neu350/H1/README.md

# H1
Resources for fly H1 visual interneuron electrophysiology experiment

Contents:

- stimulus_strips.ps - postscript file of stimulus strips for visual display.
- BarPatterns.m - matlab script to generate stimulus strips.  The random strip will generate uniquely each time this 
- h1drum.py - python 3.x code for generation of a visual GUI to interact with the stim-spinner device.
- StepperClassroomV1.0.ino - Arduino sketch to control stim-spinner device.
- spinner folder - contains schematics and part list for fabricating the StimSpinner device
