neu350/H1/spinner/README.md

This folder contains information pertaining to the fabrication of the StimSpinner device used to present rotating visual stimuli to flies as part of the H1 experiment.

Numbers in brackets correspond to components in BOM list.
