neu350/H1/spinner/StimSpinner_InteriorRendering.pdf

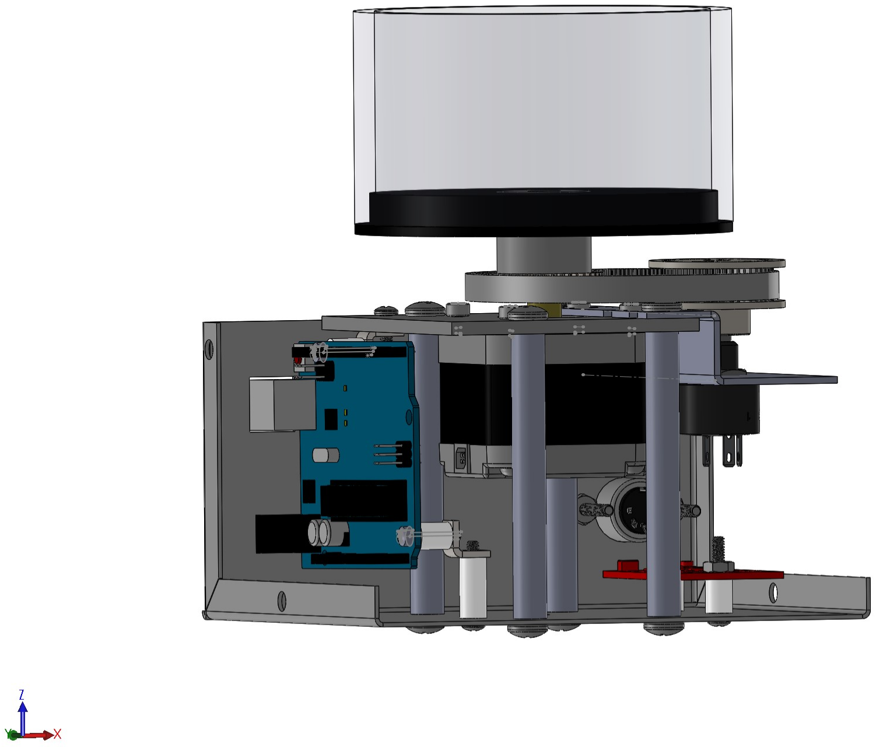
[picture p1: page 1]
