neu350/H1/spinner/StimSpinner_BOM.pdf

ITEM NO. | PART NUMBER | DESCRIPTION | QTY.
1 | plate | Motor Mount | 1
2 | base-cu-3007 | Base of Bud Box CU-3007-A | 1
3 | spacer | 5/8 Aluminum Rod | 4
4 | sheet-bend | Potentiometer Mount | 1
5 | ROB-09238 | Stepper Motor | 1
6 | BNC | BNC Bulkhead Connector | 1
7 | DIN 5 Connector (Female) | Power Connector | 1
8 | brass_sleeve | | 1
9 | 94639A207 | 5/16" Nylon Spacer | 4
10 | 94639A698 | 9/16" Nylon Spacer | 1
11 | Bracket 4-40 621 | | 2
12 | Cylinder_Base_Plate | | 1
13 | 8486K371_clear_cyli nder | 2" of Clear Acrylic Tube 3-1/2" OD x 3-1/4" ID | 1
14 | RV4LF0GSF103MA-VISHAY.STP | 5K Rotary Potentiometer | 1
15 | Arduino | | 1
16 | Big Easy Driver stp.step | Stepper Motor Driver | 1
17 | spur-gear | | 1
18 | 2662N25 | Plastic Belt Pulley | 1
19 | 7887K223 | Timing Belt | 1
20 | 91292A109 | Socket Head Screw M3x0.5mm 4mm Long | 4
21 | 91772A827 | Screw 10-32 3/8" | 8
22 | 91772A113 | Screw 4-40 3/4" | 6
23 | 91737A084 | Narrow Fillister Head Screw 4-40 1/2" | 2
24 | 91841A005 | Nut 4-40 | 3
25 | 91375A144 | Cup-Point Set Screw 6-32 1/4" | 1
26 | cover-cu-3007 | Cover of Bud Box CU-3007-A | 1
27 | 92562A234 | Socket Head Screw 10-24 1/2" | 1
A | A
B | B

2

2

1

1

SIZE A | DWG. NO. StimSpinnerBOMSHEET 1 OF 1 | REV.
SCALE:1:5 | WEIGHT:
