neu350/H1/spinner/StimSpinner_PartsList.pdf

Newark # | #/Unit | Description
30H5040 | 2 | KEYSTONE 621 MOUNTING BRACKET
08N6813 | 1 | MULTICOMP 2226A-02 Connector Housing, 2226 Series, Receptacle, 2 Positions, 2.54 mm
08N6814 | 1 | MULTICOMP 2226A-03 Connector Housing, 2226 Series, Receptacle, 3 Positions, 2.54 mm
08N6815 | 2 | MULTICOMP 2226A-04 Connector Housing, 2226 Series, Receptacle, 4 Positions, 2.54 mm
08N6818 | 1 | MULTICOMP 2226A-08 Connector Housing, 2226 Series, Receptacle, 8 Positions, 2.54 mm
08N6834 | 25 | MULTICOMP 2226TG Contact, 2226 Series, Socket, Crimp, 24 AWG, Gold Plated Contacts
08N6750 | 1 | KEYSTONE 621 MOUNTING BRACKET
08N6746 | 1 | MULTICOMP 2211S-04G Pin Header, Board-to-Board, 2.54 mm, 1 Rows, 4 Contacts, Through Hole Straight, 2211S Series
08N6744 | 1 | MULTICOMP 2211S-02G Pin Header, Board-to-Board, 2.54 mm, 1 Rows, 2 Contacts, Through Hole Straight, 2211S Series
79P9326 | 1 | SAMTEC TSW-108-09-T-S-RA Pin Header, Board-to-Board, 2.54 mm, 1 Rows, 8 Contacts, Through Hole Right Angle, TSW Series
05M4060 | 1 | BUD CU-3007-A Metal Enclosure, Minibox, Small, Aluminium, 101.6 mm, 127 mm, 152 mm
71J0171 | 1 | XP POWER PCM50UT04 AC/DC Power Supply, 3 Output, 42 W, 5 V, 5 A, 12 V, 2 A
98K6011 | 1 | VOLEX 17250 10 B1 Mains Power Cord, NEMA 5-15P to IEC 60320 C13, 2.3 m, 10 A, 125 VAC, Black
83H7885 | 1 | ETI SYSTEMS SP22G-5K Rotary Potentiometer, Conductive Plastic, 5 kohm, 1 Turns, Linear, 1 W, ± 10%, SP22G Series
67AC3850 | 1 | HIRSCHMANN MAB 5 DIN AUDIO/VIDEO CONN, JACK, 5POS, STEEL
79K4997 | 1 | MULTICOMP SPC15415 RF / Coaxial Connector, BNC Coaxial, Straight Bulkhead Jack, Solder, 50 ohm, Brass
McMaster-Carr | #/Unit | Description
91737A084 | 5 | Narrow Fillister Head Phillips Screws, High-Profile, 4-40 Thread, 1/2" Long
91841A005 | 3 | 18-8 Stainless Steel Hex Nut, 4-40 Thread Size
91772A113 | 2 | 18-8 Stainless Steel Pan Head Phillips Screw, 4-40 Thread, 3/4" Long
91772A827 | 8 | 18-8 Stainless Steel Pan Head Phillips Screw, 10-32 Thread, 3/8" Long
91292A109 | 4 | 18-8 Stainless Steel Socket Head Screw M3 x 0.5 mm Thread, 4 mm Long screw
94639A207 | 4 | Off-White Nylon Unthreaded Spacer, 1/4" OD, 5/16" Long, for Number 4 Screw Size
94639A698 | 2 | Off-White Nylon Unthreaded Spacer, 1/4" OD, 9/16" Long, for Number 4 Screw Size
91375A144 | 1 | Cup-Point Set Screw, 6-32 Thread, 1/4" Long
92562A234 | 1 | Socket Head Screw, 10-24 Thread Size, 1/2" Long
8486K371 | 2 inch | Clear Cast Acrylic Tube, 3-1/2" OD x 3-1/4" ID
SparkFun | #/Unit | Description
ROB-12859 | 1 | Big Easy Driver
ROB-09238 | 1 | Stepper motor
| 1 | Arduino Uno – R3
PRT-14340 | 1 | Medium Heatsink
PRT-17054 | | Thermal Tape 4x4" Square
SDP/SI | #/Unit | Description
Pully | 1 | A 6Z 6-40DF02508
Timing Belt | 1 | A 6R 6-0850250
