neu350/H1/spinner/[12] Cylinder_Base_Plate.pdf

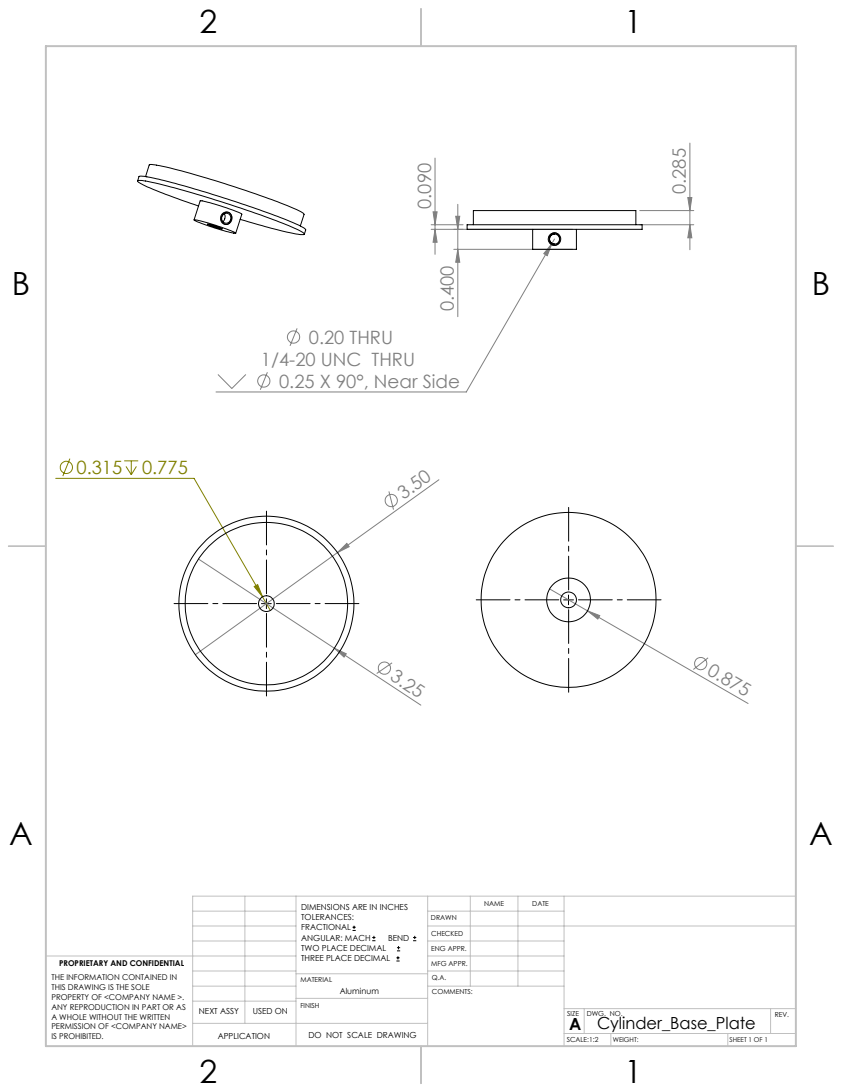
[picture p2: page 1]
0.20 THRU 1/4-20 UNC THRU 0.25 X 90°, Near Side

TOLERANCES: FRACTIONAL ANGULAR: MACH BEND TWO PLACE DECIMAL THREE PLACE DECIMAL | | NAME | DATE DIMENSIONS ARE IN INCHES

DRAWN
CHECKED
ENG APPR.

PROPRIETARY AND CONFIDENTIAL THE INFORMATION CONTAINED IN THIS DRAWING IS THE SOLE PROPERTY OF <COMPANY NAME >. ANY REPRODUCTION IN PART OR AS A WHOLE WITHOUT THE WRITTEN PERMISSION OF <COMPANY NAME> IS PROHIBITED. | | | MFG APPR.

MATERIAL Aluminum | Q.A.

NEXT ASSY | USED ON | FINISH

SIZE A | DWG. NO. Cylinder_Base_Plate | REV.

APPLICATION | | DO NOT SCALE DRAWING

SCALE:1:2 | WEIGHT: | SHEET 1 OF 1
