neu350/H1/spinner/[17] spur_gear.pdf

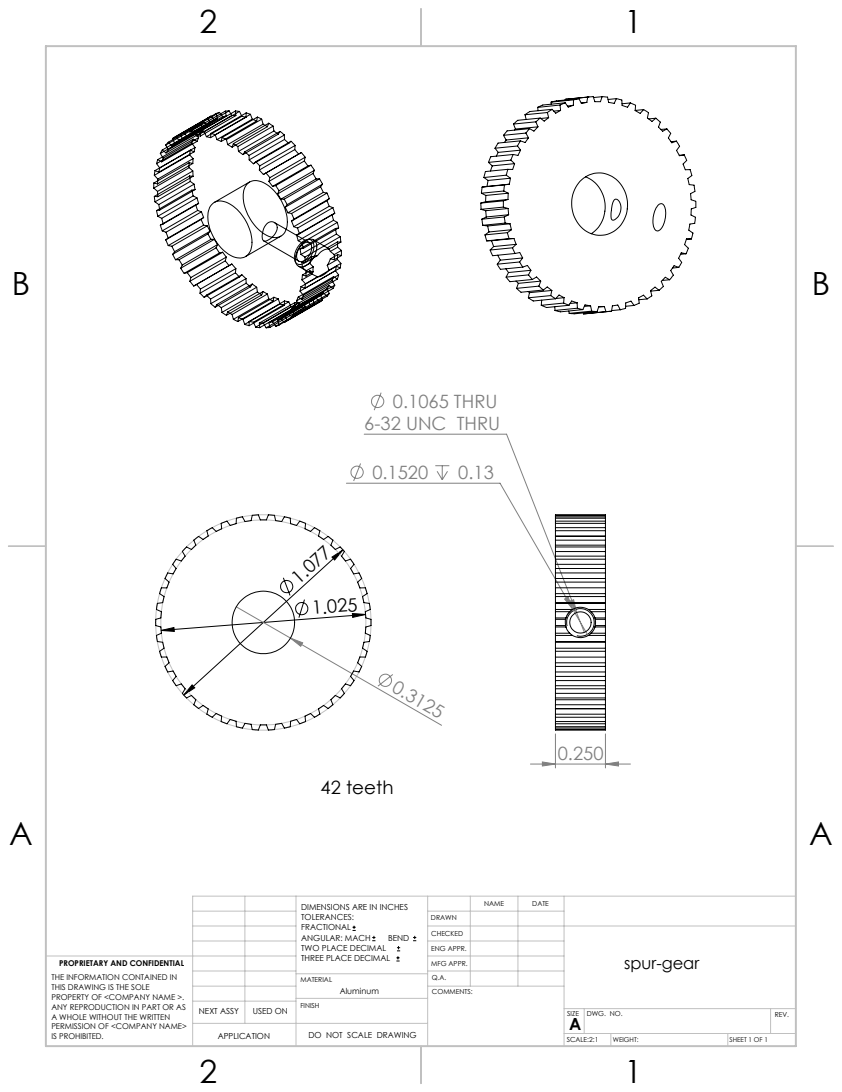
[picture p3: page 1]
0.1065 THRU 6-32 UNC THRU; 42 teeth

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

DRAWN
CHECKED | | | spur-gear
ENG APPR.

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

MATERIAL Aluminum | Q.A.

NEXT ASSY | USED ON | FINISH

SIZE A | DWG. NO. | REV.

APPLICATION | | DO NOT SCALE DRAWING

SCALE:2:1 | WEIGHT: | SHEET 1 OF 1
