neu350/H1/spinner/[1] plate.pdf

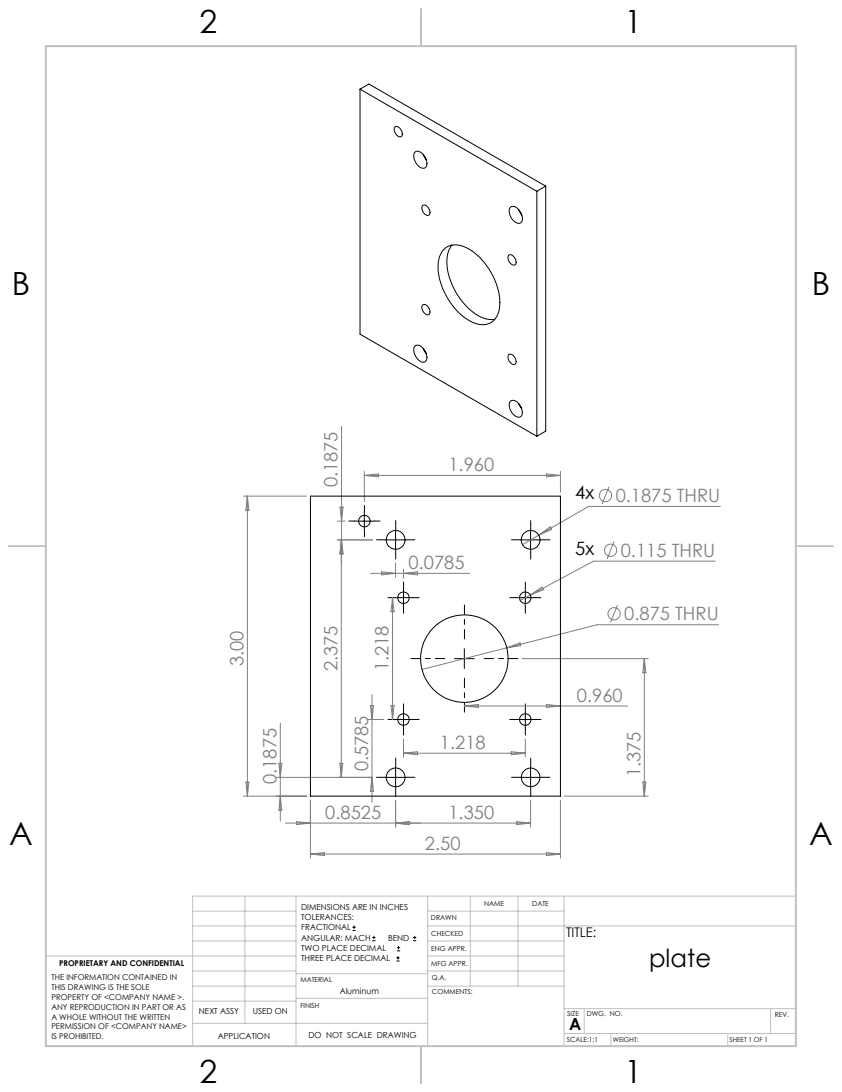
[picture p4: page 1]
0.1875 THRU; 0.115 THRU; 0.875 THRU; PROPRIETARY AND CONFIDENTIAL; plate THE INFORMATION CONTAINED IN

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

DRAWN
CHECKED | | | TITLE:

ENG APPR.

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

MATERIAL Aluminum | Q.A.

NEXT ASSY | USED ON | FINISH

SIZE A | DWG. NO. | REV.

APPLICATION | | DO NOT SCALE DRAWING

SCALE:1:1 | WEIGHT: | SHEET 1 OF 1
