neu350/H1/spinner/[3] spacer.pdf

B B

2

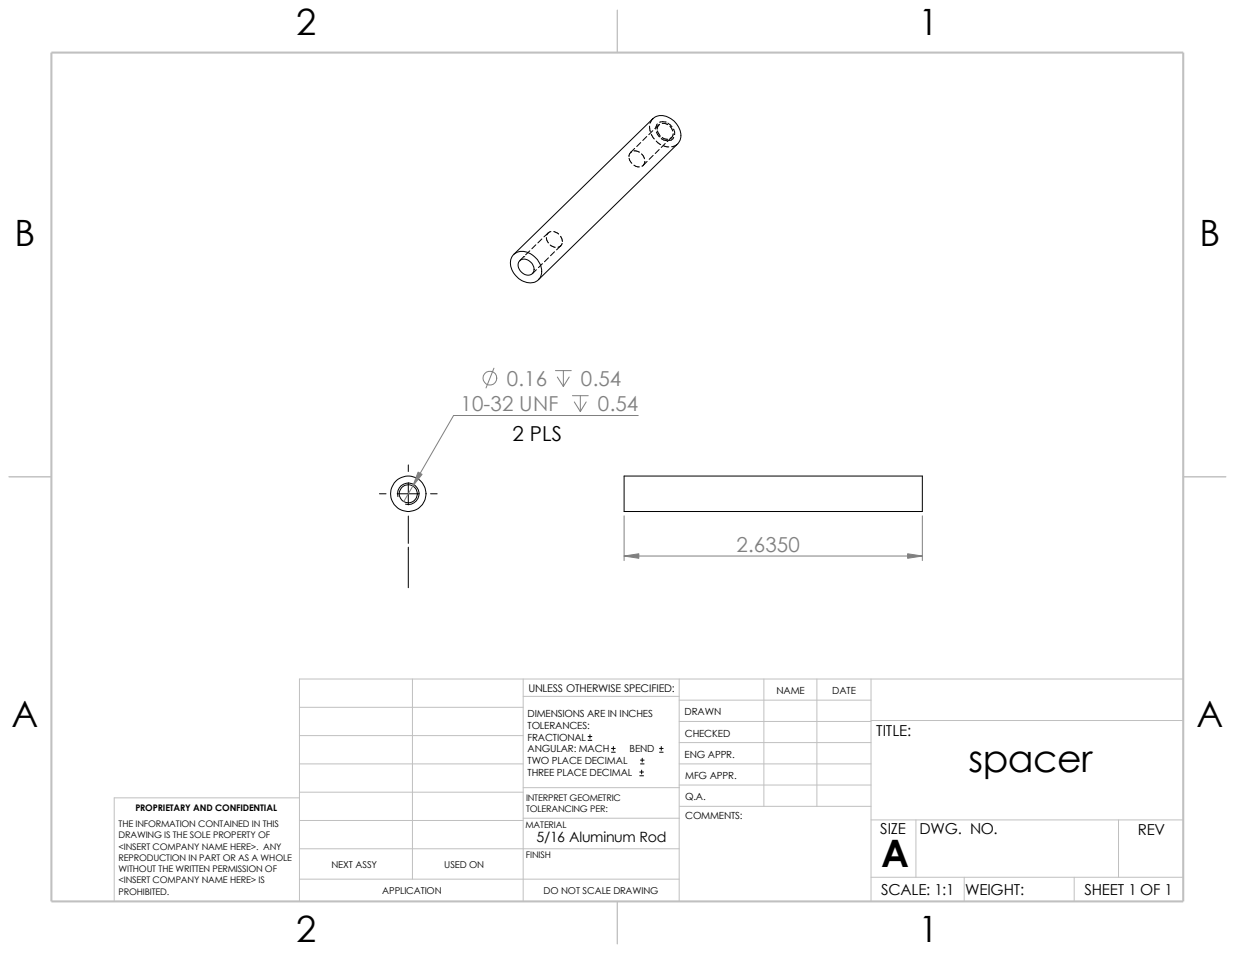
[picture p5: page 1]
10-32 UNF; COMMENTS:; INTERPRET GEOMETRIC; PROPRIETARY AND CONFIDENTIAL; TOLERANCING PER:; 2 PLS

UNLESS OTHERWISE SPECIFIED: | | NAME | DATE

DIMENSIONS ARE IN INCHES TOLERANCES: FRACTIONAL ANGULAR: MACH BEND TWO PLACE DECIMAL THREE PLACE DECIMAL | DRAWN

CHECKED | | | TITLE: spacer

ENG APPR.
MFG APPR.

THE INFORMATION CONTAINED IN THIS
DRAWING IS THE SOLE PROPERTY OF
<INSERT COMPANY NAME HERE>. ANY
REPRODUCTION IN PART OR AS A WHOLE
WITHOUT THE WRITTEN PERMISSION OF
<INSERT COMPANY NAME HERE> IS
PROHIBITED.

MATERIAL 5/16 Aluminum Rod | | SIZE A | DWG. NO. | REV

NEXT ASSY | USED ON | FINISH

APPLICATION | DO NOT SCALE DRAWING | | SCALE: 1:1 | WEIGHT: | SHEET 1 OF 1
