neu350/H1/spinner/[26] cover-cu-3007.pdf

B B

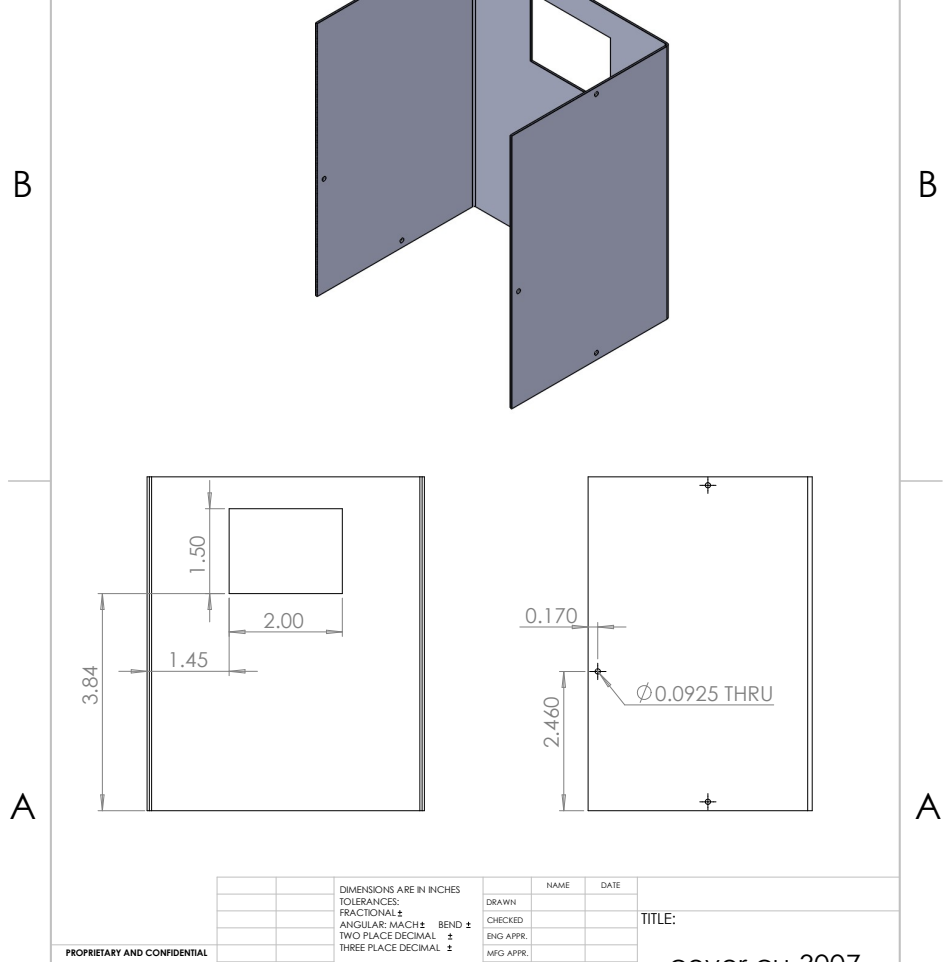
[picture p7: page 1]
ANGULAR: MACH; BEND; TITLE:; 0.0925 THRU

NAME DIMENSIONS ARE IN INCHES | DATE

TOLERANCES:
FRACTIONAL
TWO PLACE DECIMAL
THREE PLACE DECIMAL

DRAWN

CHECKED
ENG APPR.

PROPRIETARY AND CONFIDENTIAL

cover cu-3007 MFG APPR.
