neu350/H1/spinner/[2] base-cu-3007.pdf

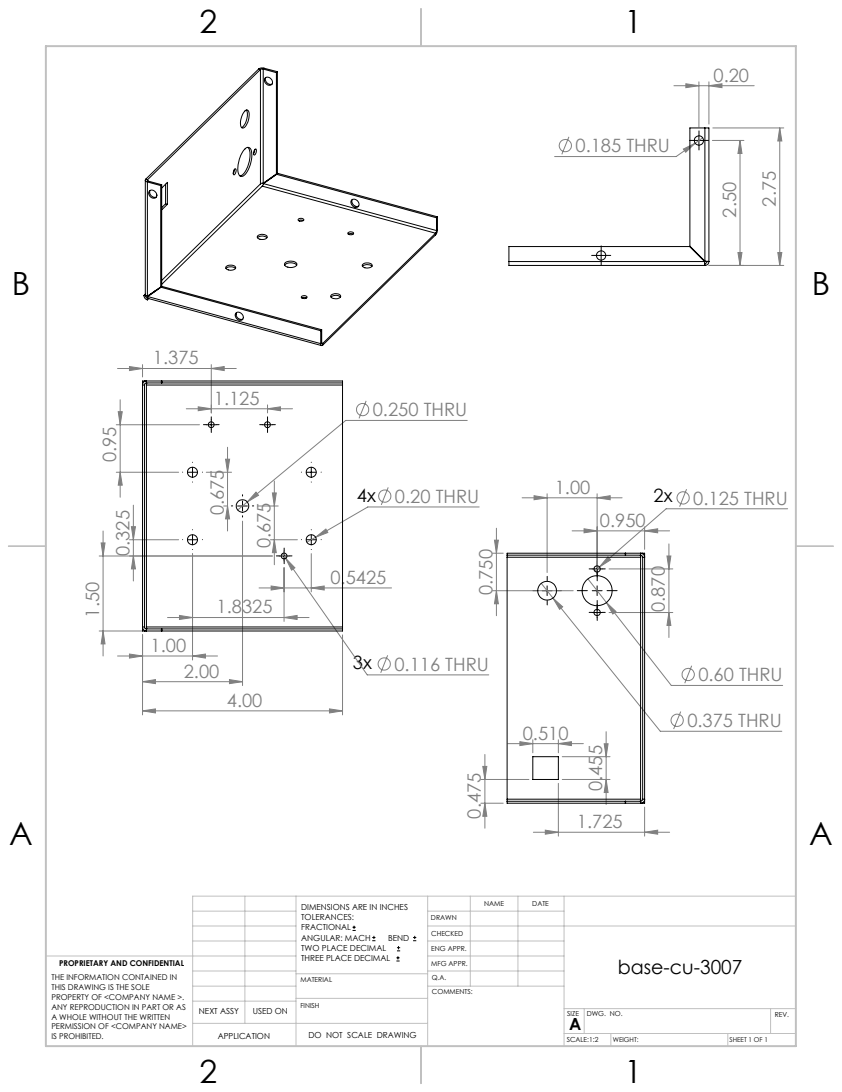
[picture p8: page 1]
0.116 THRU; 0.20 THRU; 0.250 THRU; 0.375 THRU; 0.60 THRU; 0.125 THRU; 0.185 THRU

TOLERANCES: FRACTIONAL ANGULAR: MACH BEND TWO PLACE DECIMAL THREE PLACE DECIMAL | | NAME | DATE DIMENSIONS ARE IN INCHES | base-cu-3007 PROPRIETARY AND CONFIDENTIAL

DRAWN
CHECKED
ENG APPR.

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

MATERIAL | Q.A.

NEXT ASSY | USED ON | FINISH

SIZE A | DWG. NO. | REV.

APPLICATION | | DO NOT SCALE DRAWING

SCALE:1:2 | WEIGHT: | SHEET 1 OF 1
