neu350/H1/spinner/[4] sheet-bend.PDF

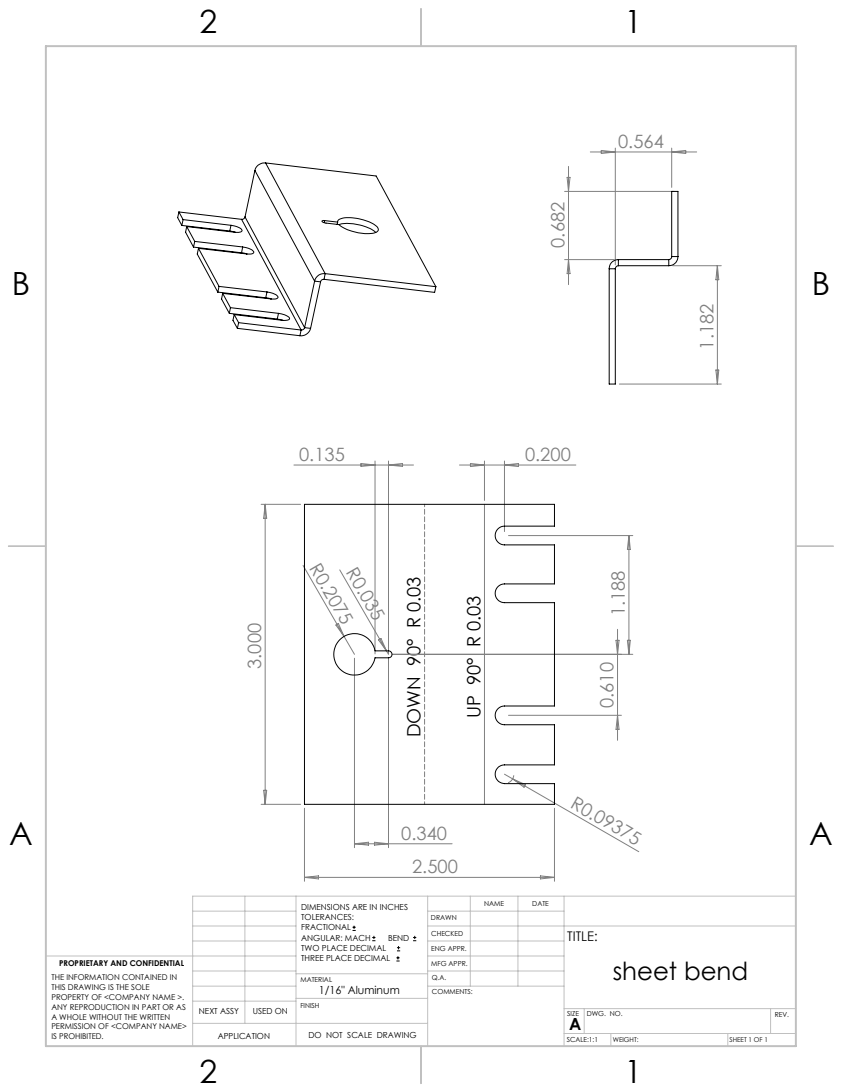
[picture p9: page 1]
DOWN 90° R 0.03

TOLERANCES: FRACTIONAL ANGULAR: MACH BEND TWO PLACE DECIMAL THREE PLACE DECIMAL | | NAME | DATE DIMENSIONS ARE IN INCHES | sheet bend PROPRIETARY AND CONFIDENTIAL

DRAWN
CHECKED | | | TITLE:
ENG APPR.

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

MATERIAL 1/16" Aluminum | Q.A.

NEXT ASSY | USED ON | FINISH

SIZE A | DWG. NO. | REV.

APPLICATION | | DO NOT SCALE DRAWING

SCALE:1:1 | WEIGHT: | SHEET 1 OF 1
