neu350/H1/spinner/StimSpinner_AssembledRendering.pdf

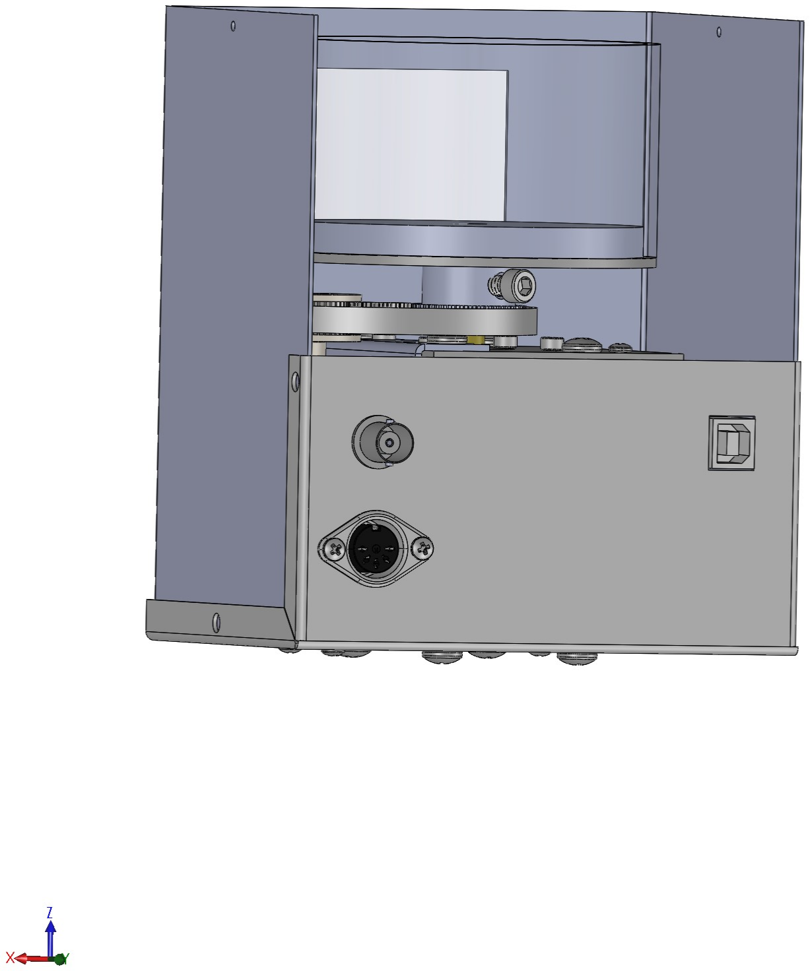
[picture p10: page 1]
